beetlebugorg/pinkstuff-basket/docs/hero-dark.png

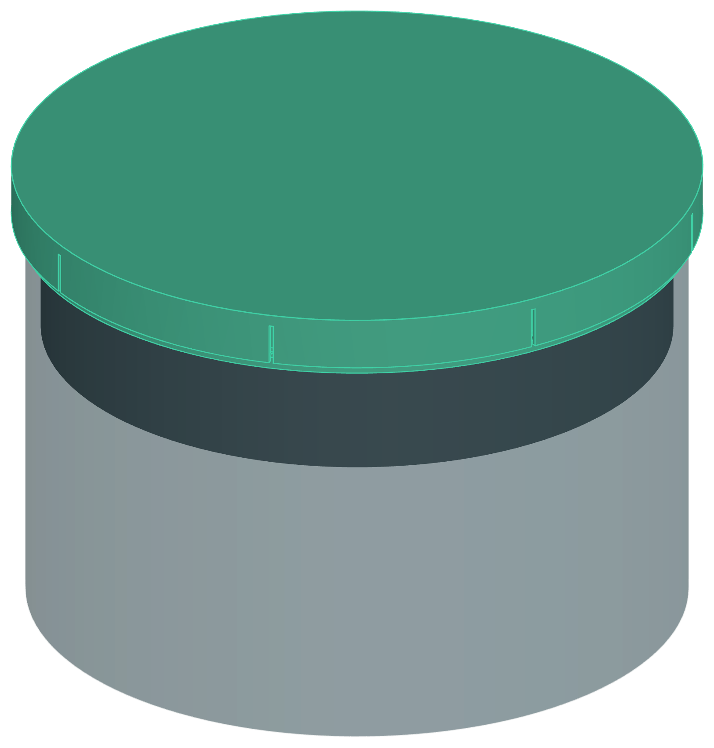
docs/hero-dark.png
