beetlebugorg/pinkstuff-basket/cad/cutting-ring-assembly.step

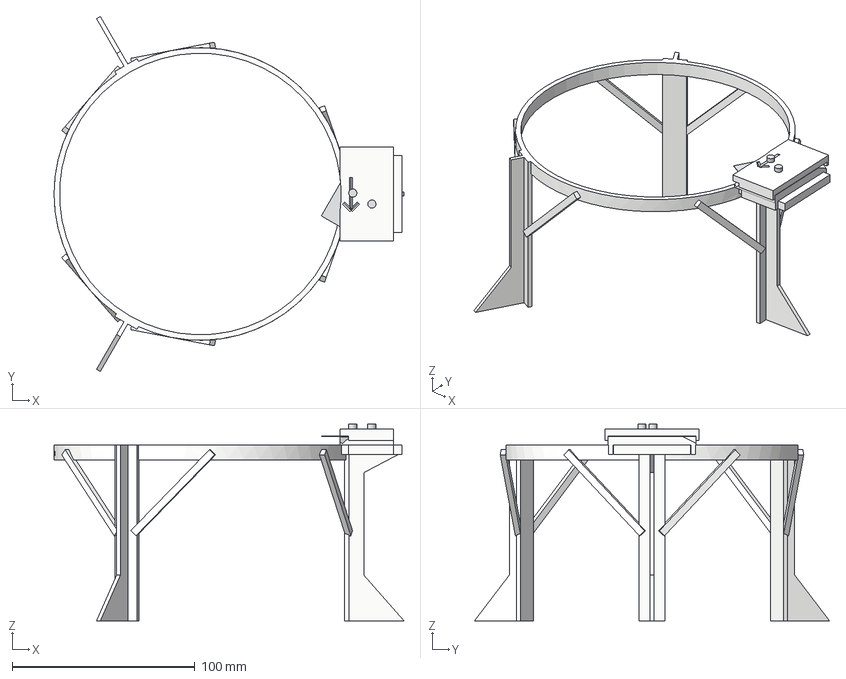
[picture p13: CAD file, 2026-11-06]
cad/cutting-ring-assembly.step
191.4 x 194.2 x 107.5 mm
cutting_ring
cartridge_base
clamp_plate
m2_5_screw
m2_5_insert
razor_blade
