beetlebugorg/pinkstuff-basket/cad/desiccant-assembly.step

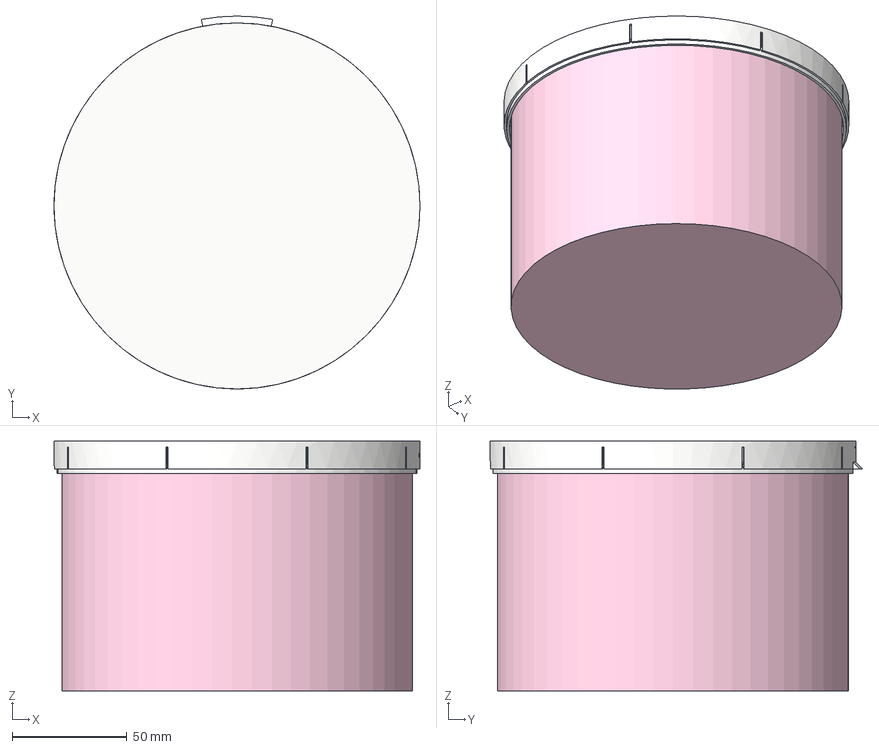
[picture p14: CAD file, 2026-11-06]
cad/desiccant-assembly.step
159.3 x 162.3 x 108.8 mm
collar
basket
lid
jug
