beetlebugorg/pinkstuff-basket/cad/jig_cart.step

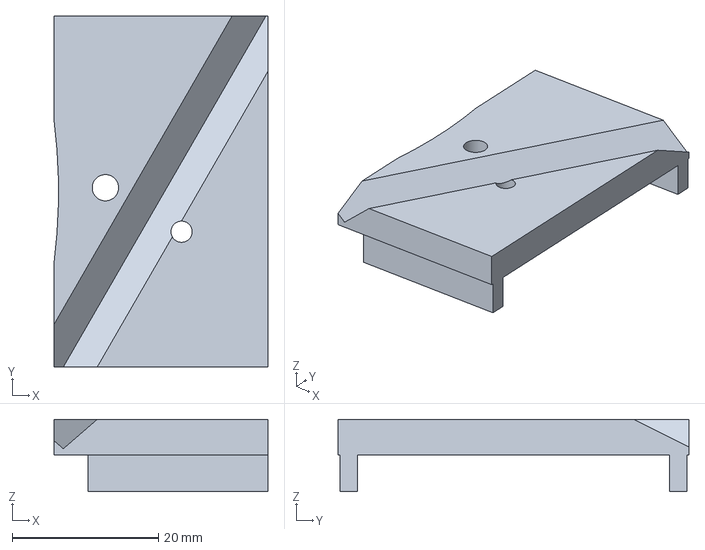
[picture p15: CAD file, 2026-11-06]
cad/jig_cart.step
29.2 x 48.0 x 9.88 mm
