beetlebugorg/pinkstuff-basket/cad/jig_clamp.step

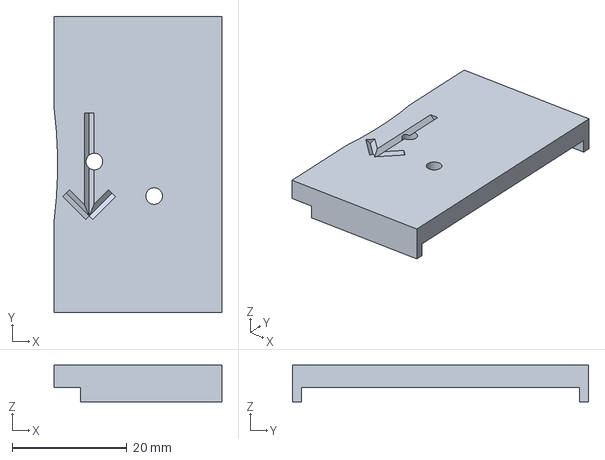
[picture p16: CAD file, 2026-11-06]
cad/jig_clamp.step
29.2 x 51.6 x 6.38 mm
