beetlebugorg/pinkstuff-basket/cad/fit_arc.step

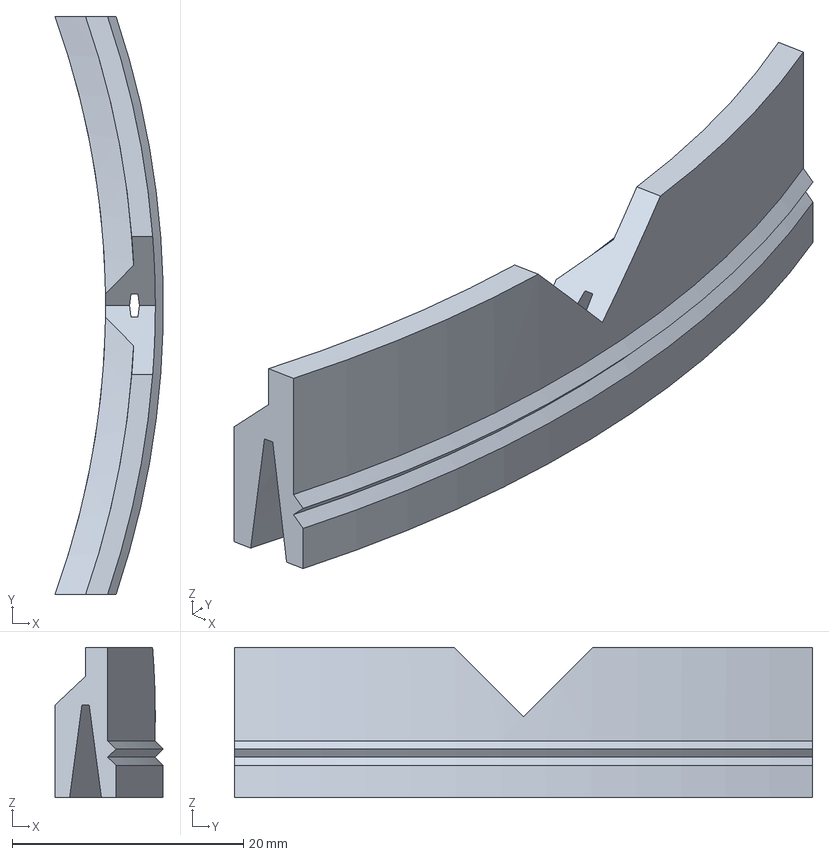
[picture p17: CAD file, 2026-11-06]
cad/fit_arc.step
9.36 x 50.0 x 13.0 mm
