beetlebugorg/pinkstuff-basket/cad/collar.step

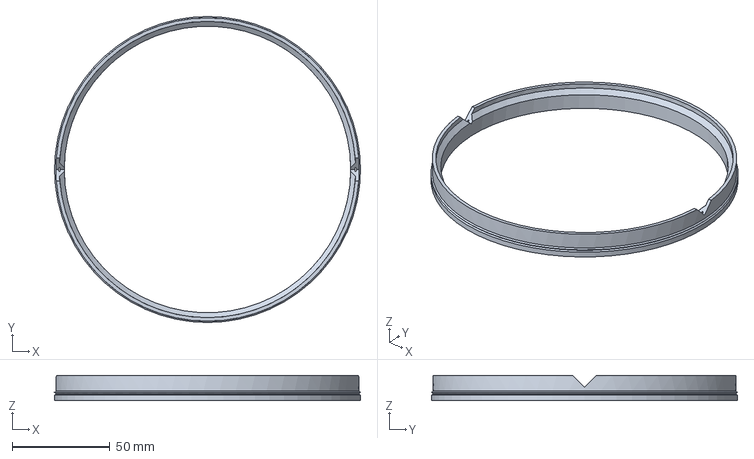
[picture p18: CAD file, 2026-11-06]
cad/collar.step
156.8 x 156.8 x 13.0 mm
