beetlebugorg/pinkstuff-basket/cad/basket.step

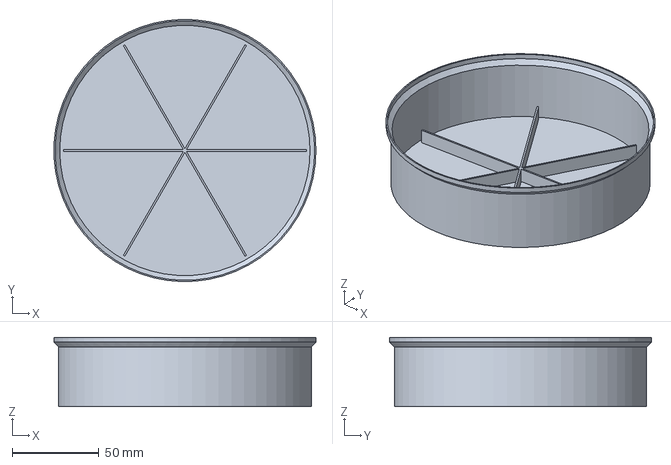
[picture p19: CAD file, 2026-11-06]
cad/basket.step
151.1 x 151.1 x 40.0 mm
