beetlebugorg/pinkstuff-basket/cad/lid.step

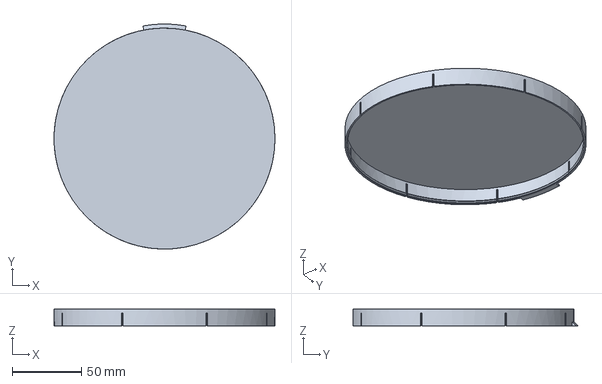
[picture p20: CAD file, 2026-11-06]
cad/lid.step
159.3 x 162.3 x 12.2 mm
