beetlebugorg/pinkstuff-basket/cad/jig.step

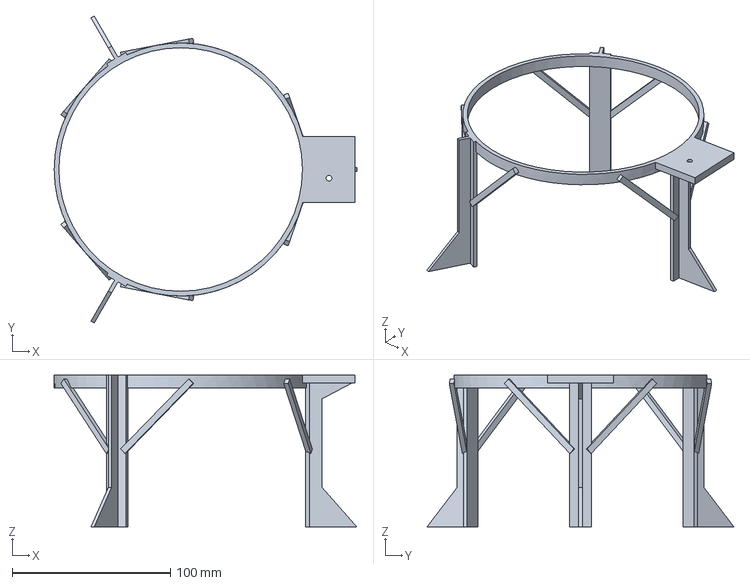
[picture p21: CAD file, 2026-11-06]
cad/jig.step
191.4 x 194.2 x 96.0 mm
