beetlebugorg/pinkstuff-basket/(list of files, cad)

Other CAD files:
stl/basket.stl
stl/collar.stl
stl/fit_arc.stl
stl/jig.stl
stl/jig_cart.stl
stl/jig_clamp.stl
stl/lid.stl
