beetlebugorg/pinkstuff-basket/docs/measure/blade-1.jpg

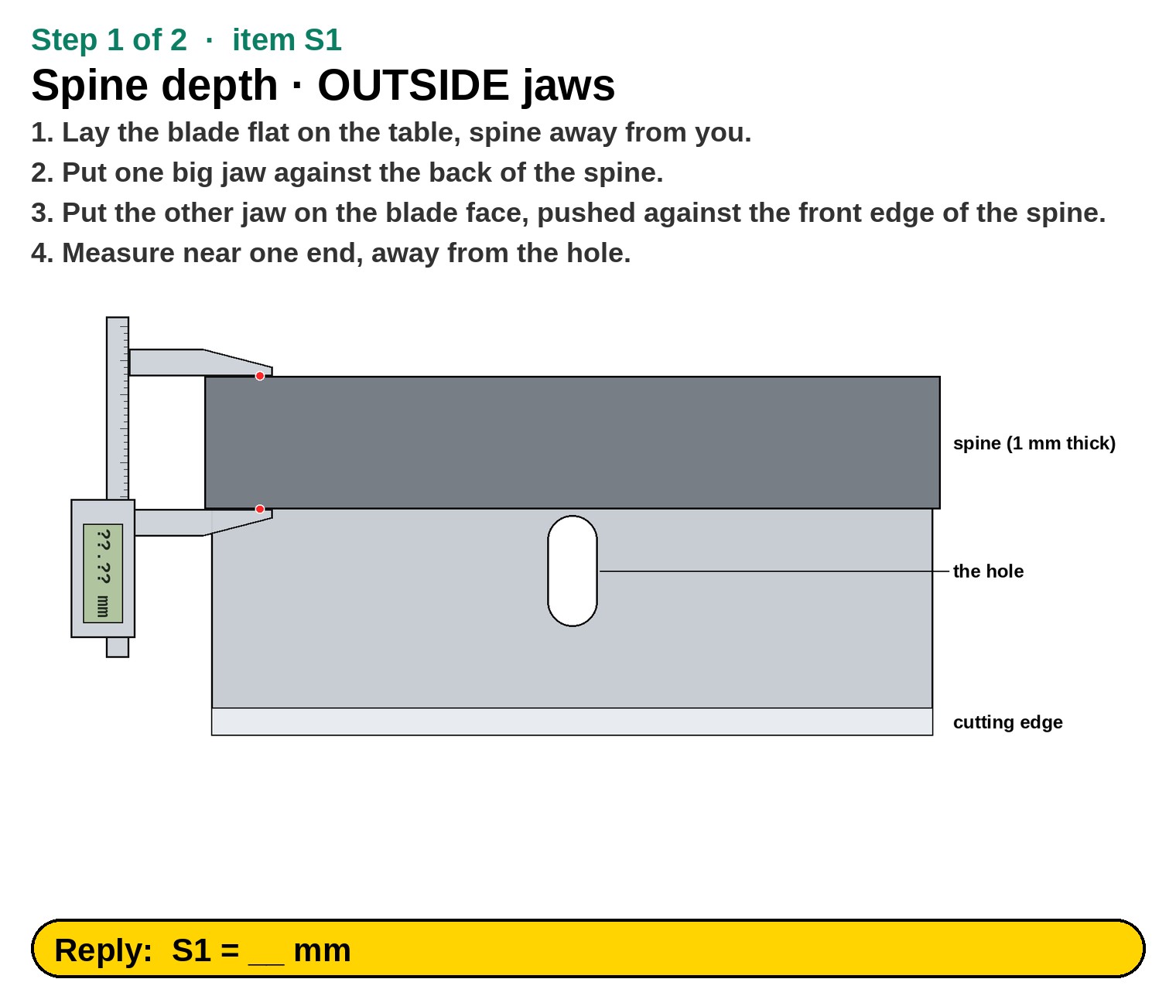
docs/measure/blade-1.jpg
