beetlebugorg/pinkstuff-basket/docs/measure/blade-2.jpg

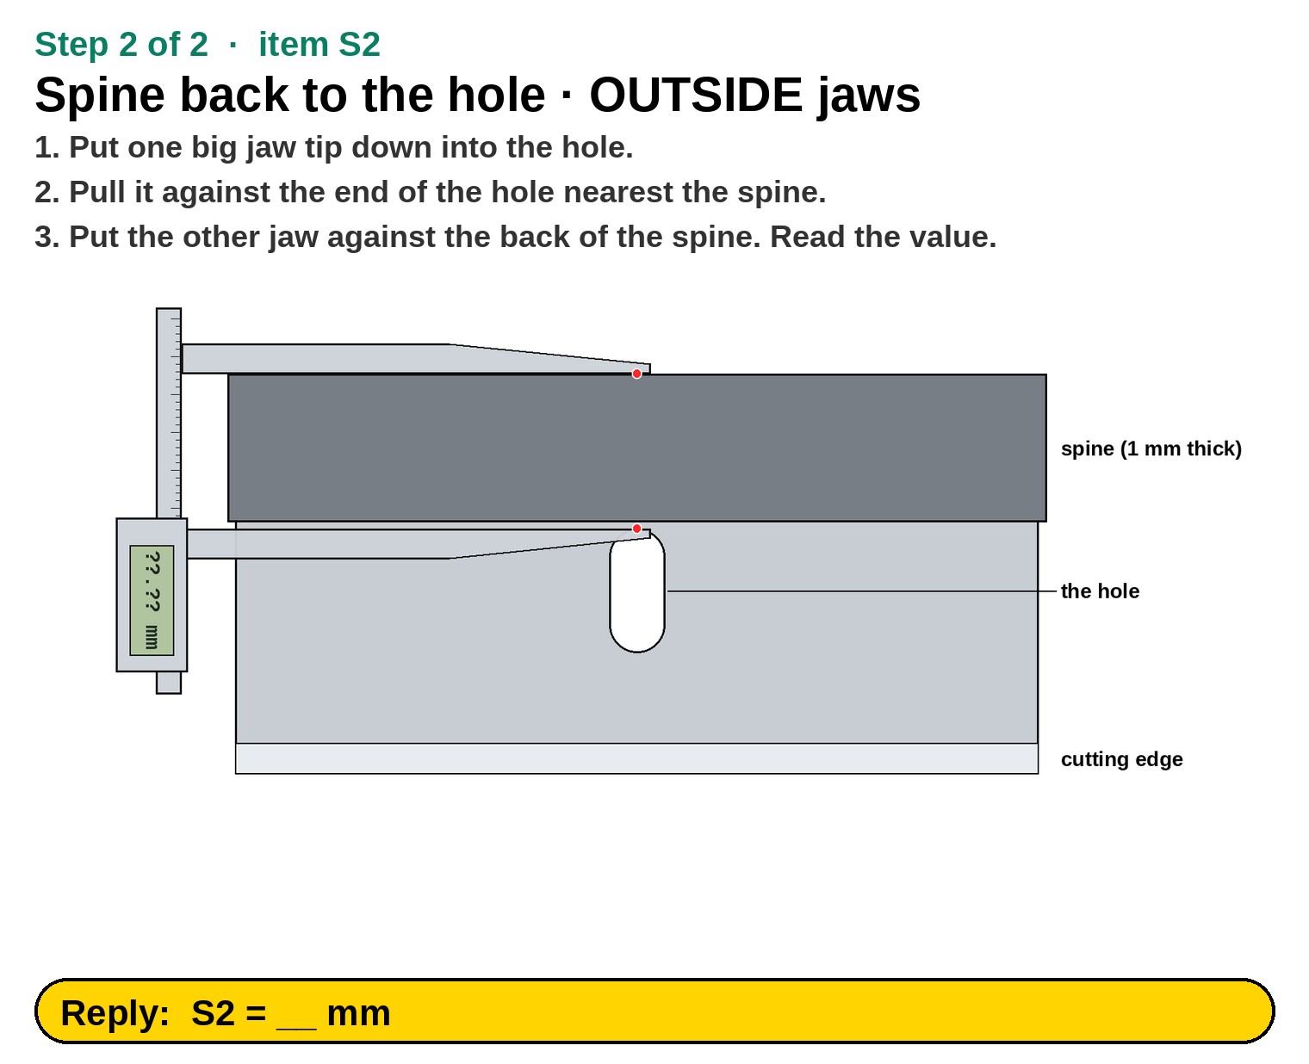
docs/measure/blade-2.jpg
