beetlebugorg/pinkstuff-basket/(commit log)

2026-11-05 Pink Stuff desiccant basket: collar, basket, lid, and cutting ring
    Build123d model with a fit check, STL files in print orientation, the
    Printdeck build (printdeck.yml, TAZ Workhorse SE profiles with white PLA),
    and the build PDF.
    [basket.step, basket.stl, collar.step, collar.stl, desiccant-assembly.step, fit_arc.step, fit_arc.stl, jig.step]
2026-11-05 Faster, cheaper prints; add the license
    - Print on pla-0.30-fast with faster walls. One set is 61 g and 2 h 43 min.
    - Floor and lid: long straight 2 mm slots between 1 mm bars, 3 layers thick.
    - Basket: no side slots, four floor ribs.
    - PDF: values for each part and for the count, in separate columns.
    - LICENSE.md: MIT for the code, CC BY 4.0 for the designs, AGPL-3.0 for profiles/.
    [basket.step, basket.stl, collar.step, desiccant-assembly.step, fit_arc.step, jig.step, jig_cart.step, jig_pin.step]
2026-11-05 Cutting ring: angled blade, measured blade, load-the-blade step; counts of 1
    - The blade sits at 30 deg to the jug wall. The tip pierces first and the
    edge slices the wall. Turn the jug clockwise; an arrow on the cartridge
    shows the direction.
    - Blade sizes from the user's blade: 38.9 mm edge, 39.7 mm spine, 1.0 mm
    spine, 0.25 mm blade, 19.4 mm wide, with its centre hole.
    - The fit check tests 19.4 and 17.5 mm blades with the jug off centre.
    - PDF: a Load the blade step. printdeck.yml: a Cutting ring assembly with
    the blade. cad/cutting-ring-assembly.step.
    - All part counts are 1 for the first test.
    [basket.step, collar.step, cutting-ring-assembly.step, desiccant-assembly.step, fit_arc.step, jig.step, jig.stl, jig_cart.step]
2026-11-05 Cartridge: widen the blade slot to 1.0 mm
    The 0.6 mm slot closed up in the print. The blade stopped short, the
    edge stayed inside the cartridge, and the spine blocked the pin hole.
    The spine pocket stays at 1.5 mm (new value POCKET_CLR).
    [basket.step, collar.step, cutting-ring-assembly.step, desiccant-assembly.step, fit_arc.step, jig.step, jig_cart.step, jig_cart.stl]
2026-11-05 Cutting ring: M2.5 screw and heat-set insert, 45 deg leg braces; faster speeds
    - An M2.5 x 12 screw goes through the cartridge into a heat-set insert in the
    shelf. It clamps the cartridge, and its shank stops the blade. The printed
    lock pin is removed.
    - Two 45 deg braces on each leg. One leg is under the shelf and braces it.
    The feet flare out on the table.
    - Faster print speeds for all parts (print 70, infill 75, walls 60/70 mm/s).
    - The fill amount for the basket: 400 g, from the solid-model volume and
    the brine space.
    [basket.step, collar.step, cutting-ring-assembly.step, desiccant-assembly.step, fit_arc.step, jig.step, jig.stl, jig_cart.step]
2026-11-05 Basket and lid: print the floor and plate as an open infill grid
    The floor and the lid plate had 320 short slots with round ends. Each
    slot printed with its own wall loops, about 190 retractions per floor
    layer. The floor and the plate are now solid in the model. The part
    settings print them with no skin and connected lines infill 2.5 mm
    apart. The openings are 2 mm square, with 2 retractions per layer.
    Printdeck slice: basket 59 to 45 min, lid 51 to 31 min. The ribs are
    1.0 mm (2 lines) and 8 mm tall. The Cura support check retries a
    stalled CuraEngine after 2 min, up to 6 times.
    [basket.step, basket.stl, collar.step, cutting-ring-assembly.step, desiccant-assembly.step, fit_arc.step, jig.step, jig_cart.step]
2026-11-05 Images: new hero images
    The hero images show the current basket and lid.
2026-11-05 PDF: open grid floor, fill amount, new print times
    The PDF describes the open grid floor and lid plate, and the settings
    that print them. It has the 400 g fill amount and the print times from
    the Printdeck slice.
2026-11-06 Bond the lid pull tab to the skirt, and print all parts on a brim
    The pull tab was a flat wedge on the round skirt. Its ends stood
    1.2 mm off the skirt and hung free. The tab now follows the curve of
    the skirt, so its full length bonds to the skirt.
    All parts now print with a 10-line brim on the outside. The brim
    holds the large thin parts flat on the bed. It stays out of the open
    grid and the bores. The brim adds 2 to 7 min to each part.
    [basket.step, collar.step, cutting-ring-assembly.step, desiccant-assembly.step, fit_arc.step, jig.step, jig_cart.step, lid.step]
2026-11-06 Firm up the lid snap, widen the lid fingers, and print faster
    The lid was loose and did not click into place. The snap goes from
    0.5 to 0.6 mm (1.41 % strain, limit 1.5 %). The skirt now has 8 slits
    in place of 16, so each finger is about 63 mm wide. The wide fingers
    are stiffer, and the skirt walls print in long runs.
    The speeds go up on all parts: outer wall 75 mm/s, inner walls and
    print 90 mm/s, infill 100 mm/s, accelerations 2000 to 3000 mm/s2. The
    flow stays at 15 mm3/s or less. PLA prints at 220 C for this flow.
    One set now prints in 1 h 42 min (it was 2 h 00 min).
    [basket.step, collar.step, cutting-ring-assembly.step, desiccant-assembly.step, fit_arc.step, jig.step, jig_cart.step, lid.step]
2026-11-06 Stop the hole offset on the rings, and fix the basket slice
    The white PLA roll sets hole_xy_offset to 0.25 mm. Cura sees the inner
    face of the collar, the basket, and the lid as a hole in each layer,
    so the slice moved each inner face out 0.25 mm. The basket wall
    printed 0.72 mm thick, and the lid snap was 0.25 mm in place of 0.5 mm.
    That made the lid loose. These three parts now set hole_xy_offset to 0.
    The snap goes back to 0.5 mm. The lid keeps its 8 wide fingers.
    The 4 floor ribs touched the wall and cut each rib layer into 8
    islands. Cura made 5 travels of up to 145 mm on each of these layers.
    The ribs are now a star of 6 spokes that stops 2 mm from the wall.
    Each rib layer is 2 island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
    [basket.step, basket.stl, collar.step, cutting-ring-assembly.step, desiccant-assembly.step, fit_arc.step, jig.step, jig_cart.step]
2026-11-06 Clamp the blade by its spine with a two-plate cartridge
    The blade was loose in the cartridge. The blade slot was 1.0 mm for a
    0.25 mm blade, and nothing pressed on the blade. The spine depth was
    an estimate (5.5 mm). The measured spine is 6.85 mm deep.
    The cartridge is now two plates. The spine sits in a pocket on the
    base. The pocket ends stop the blade along the edge. The clamp plate
    goes on top. The M2.5 screw goes through both plates, behind the
    spine, into the insert in the shelf. The screw squeezes the spine
    between the plates. A heel on the clamp plate keeps it level.
    The cutting ring does not change. Its layout uses JIG_BLADE_D (the
    first blade value), so stl/jig.stl stays the same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
    [basket.step, collar.step, cutting-ring-assembly.step, desiccant-assembly.step, fit_arc.step, jig_cart.step, jig_cart.stl, jig_clamp.step]
2026-11-06 Hold the blade by its hole with a screw into the base
    The old cartridge had a 0.25 mm spine pocket. That is less than one
    layer, so it did not print, and nothing held the blade in position.
    Now an M2.5 x 8 screw goes through the clamp plate and the hole in
    the blade into a heat-set insert in the base. A slot under the clamp
    plate fits the spine, so the blade goes in one way only. The base has
    a V-groove for the lower half of the spine. Both plates print upside
    down. The M2.5 x 12 lock screw holds the cartridge on the shelf.
    The base is 1 mm thicker for the insert, so the cut is at 101 mm.
    The ring STL does not change.
    [cutting-ring-assembly.step, desiccant-assembly.step, jig_cart.step, jig_cart.stl, jig_clamp.step, jig_clamp.stl]
